abersailbot/dewi-hardware/firstdraftwiringdiagramdewi.jpg

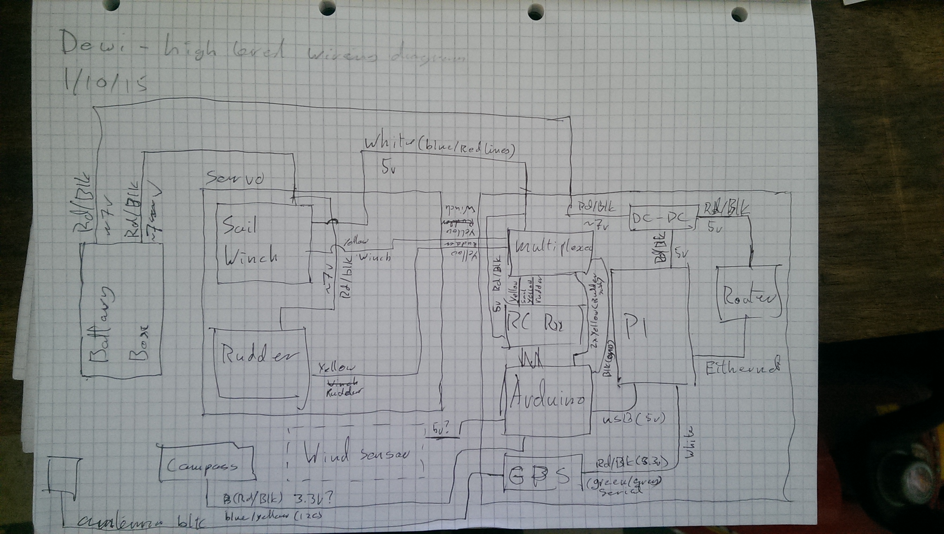
firstdraftwiringdiagramdewi.jpg
