abersailbot/dewi-hardware/README.md

# dewi-hardware
Hardware designs and issue tracking for Dewi.
