abersailbot/dewi-hardware/hardware-spec.rst

===============
Dewi's hardware
===============

Weight: 17.5kg (full electronics, without batteries)
