abersailbot/dewi-hardware/(list of files, drawings)

Other design files:
pi-expansion/Pi-Expansion.dsn
