abersailbot/dewi-hardware/pi-expansion/Pi-Expansion.kicad_pcb

## KiCad design pi-expansion/Pi-Expansion.kicad_pcb (2016-11-21, last stored version)

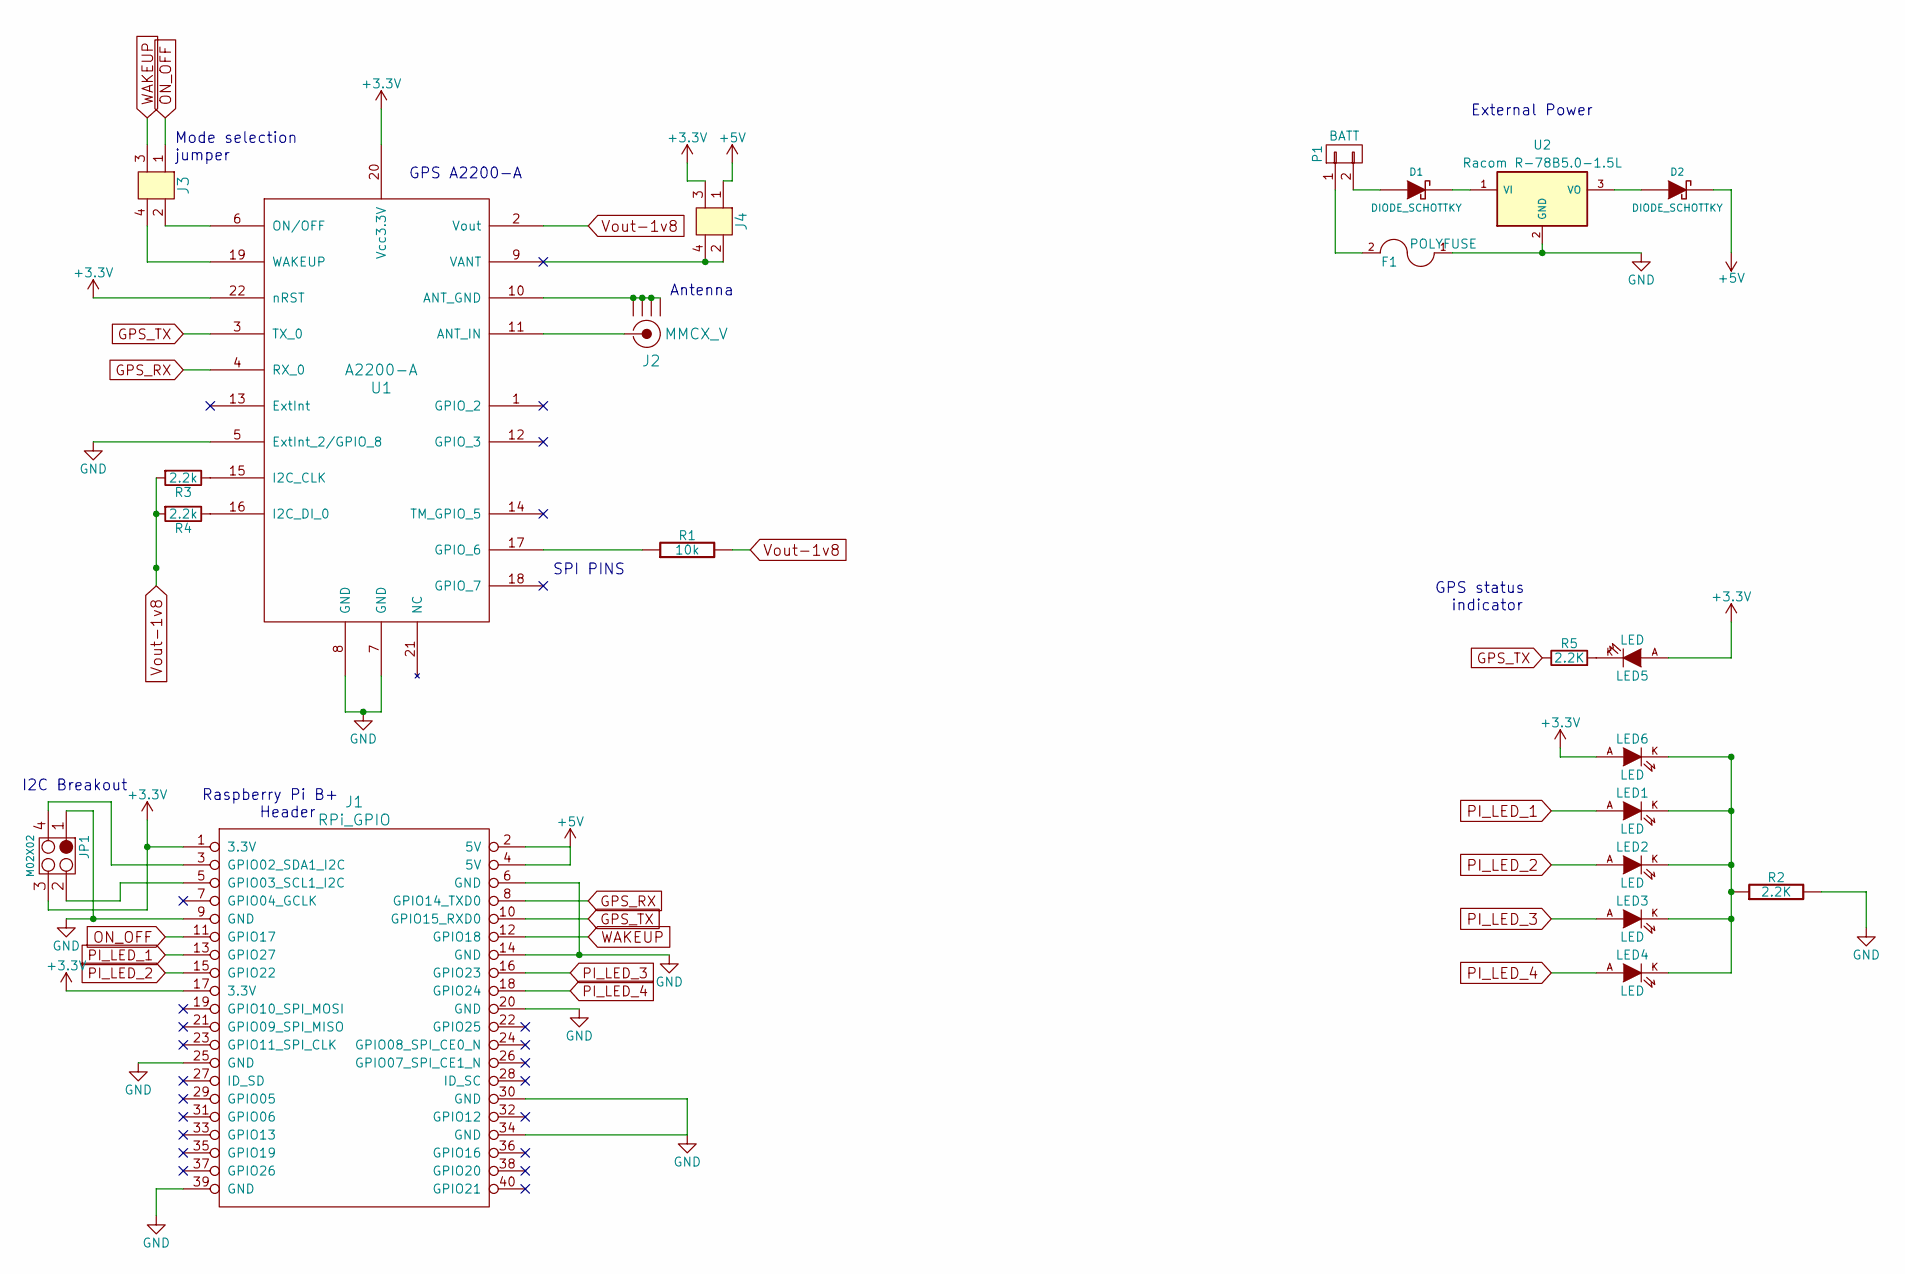
[picture p2: schematic Pi-Expansion.sch, Captain H.Morgan]

Parts:
D1, D2: DIODE_SCHOTTKY; SOD-323
F1: POLYFUSE; Fuse_SMD1206_HandSoldering
J1: RPi_GPIO; Pin_Header_Straight_2x20
J2: MMCX_H; MMCX_V; Manufacturer Part Number 142-0711-821
J3, J4: PINHEADER_2X2_SMD; Pinhead_2x2_SMD; Manufacturer Part Number 0015912040
JP1: M02X02; Socket_MOLEX-KK-RM2-54mm_Lock_4pin_straight
LED1, LED2, LED3, LED4, LED5, LED6: LED; LED-1206
P1: BATT; Socket_MOLEX-KK-RM2-54mm_Lock_2pin_straight
R1: 10k; 1206
R2, R5: 2.2K; 1206
R3, R4: 2.2k; 1206
U1: A2200-A
U2: Racom R-78B5.0-1.5L; DCDC-Conv_Recom_R-78HBxx-0.5

Connections:
+3V3: J1.1 (3.3V), J1.17 (3.3V), J4.3, JP1.3, LED5.A, LED6.A, U1.20 (Vcc3.3V), U1.22 (nRST)
+5V: D2.K, J1.2 (5V), J1.4 (5V), J4.1
GND: F1.1, J1.6 (GND), J1.9 (GND), J1.14 (GND), J1.20 (GND), J1.25 (GND), J1.30 (GND), J1.34 (GND), J1.39 (GND), JP1.1, R2.2, U1.5 (ExtInt_2/GPIO_8), U1.7 (GND), U1.8 (GND), U2.2 (GND)
GPS_RX: J1.8 (GPIO14_TXD0), U1.4 (RX_0)
GPS_TX: J1.10 (GPIO15_RXD0), R5.1, U1.3 (TX_0)
unnamed: D1.A, P1.2
unnamed: D1.K, U2.1 (VI)
unnamed: D2.A, U2.3 (VO)
unnamed: F1.2, P1.1
unnamed: J1.3 (GPIO02_SDA1_I2C), JP1.4
unnamed: J1.5 (GPIO03_SCL1_I2C), JP1.2
unnamed: J2.1 (RF), U1.11 (ANT_IN)
unnamed: J2.2 (GND1), J2.3 (GND2), J2.4 (GND3), J2.5 (GND4), U1.10 (ANT_GND)
unnamed: J3.2, U1.6 (ON/OFF)
unnamed: J3.4, U1.19 (WAKEUP)
unnamed: J4.2, J4.4, U1.9 (VANT)
unnamed: LED1.K, LED2.K, LED3.K, LED4.K, LED6.K, R2.1
unnamed: LED5.K, R5.2
unnamed: R1.1, U1.17 (GPIO_6)
unnamed: R3.1, U1.15 (I2C_CLK)
unnamed: R4.1, U1.16 (I2C_DI_0)
ON_OFF: J1.11 (GPIO17), J3.1
PI_LED_1: J1.13 (GPIO27), LED1.A
PI_LED_2: J1.15 (GPIO22), LED2.A
PI_LED_3: J1.16 (GPIO23), LED3.A
PI_LED_4: J1.18 (GPIO24), LED4.A
Vout-1v8: R1.2, R3.2, R4.2, U1.2 (Vout)
WAKEUP: J1.12 (GPIO18), J3.3

Notes on the sheet:
SPI PINS
Mode selection jumper
GPS A2200-A
I2C Breakout
External Power
GPS status indicator
Raspberry Pi B+ Header
Antenna

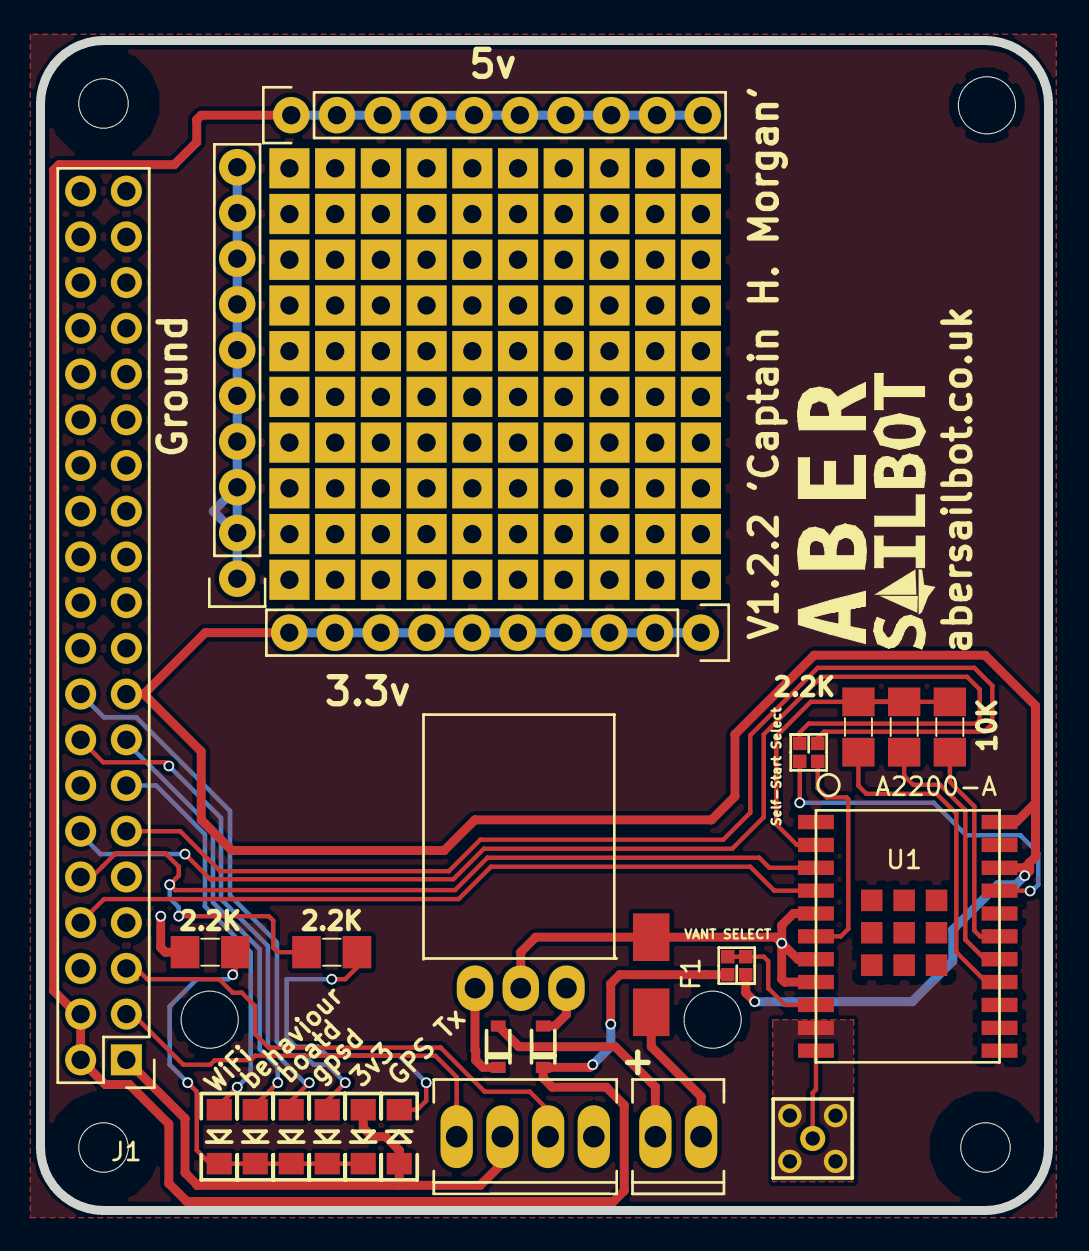
[picture p3: board Pi-Expansion.kicad_pcb from above]

Board: 2 copper layers, 56.0 x 65.0 mm, 27 parts (0 on the bottom side), 28 nets.

Other parts of the board:
1111, 1112, 1121: RPi_Hat_Mounting_Hole
ARDUINO_SHIELD: val**; ARDUINO_SHIELD_3_HOLE
svg2mod: G***; Sailbot_Logo
