abersailbot/dewi-hardware/(threads)

Thread 1 (2015-08-31):

Fix Handle

Danyc0, 2015-08-31:
The front handle of Dewi needs fixing so that the jib can be attached. Will need Epoxy and Fibreglass we have to find somewhere.

Do not close this ticket until the sails have been attached and tensioned. Re-open if the handle breaks again

Danyc0, 2015-09-01:
Handle fixed, waiting for attaching and tensioning to close the ticket

Closed 2015-09-01.

Thread 10 (2015-08-31):

Build new wind sensor

colinsauze, 2015-08-31:
Build a new wind sensor and wind sensor mast to replace the previous lost/broken one. Possibly integrate Halie's luffing sensors.

TomGC96, 2016-05-17:
New Wind Sensor and Vane attached

Closed 2016-05-17.

Thread 2 (2015-08-31):

Fix Keel

Danyc0, 2015-08-31:
Epoxy and fibreglass the bottom of the keel back onto Dewi's hull. The broken part of the keel can be found in a clear clipped plastic box.

Do not close this ticket until the epoxy has set and has had some gentle strength testing. Re-open this ticket if the it breaks again

Danyc0, 2015-09-01:
Keel fixed!

Closed 2015-09-01.

Thread 5 (2015-08-31):

New Stand

colinsauze, 2015-08-31:
Make a new stand that is:
1. collapsable
2. lightweight
3. has two wheels

naturesyouth, 2015-09-04:
and go faster flames

Tebazil12, 2016-06-05:
Fixed old stand

TomGC96, 2016-06-05:
Have created a new portable stand for Dewi, however may need some adjusting and requires attaching side beams.

TomGC96, 2016-06-17:
New portable stand has been sanded to fit and side beams have been attached.

Closed 2016-06-17.

Thread 6 (2015-08-31):

Fix power distribution

colinsauze, 2015-08-31:
Reconnect 5V regulator/DC-DC converter. Make sure that GPS and compass have 3.3V power supplies, should be we use the Arduino 3.3V output to do this?

colinsauze, 2015-09-04:
Power distribution done.

Closed 2015-09-04.

Thread 7 (2015-08-31):

Reconnect GPS

colinsauze, 2015-08-31:
Reconnect the GPS USB to serial converter and power supply.

naturesyouth, 2015-09-01:
gps works, but the wire loom needs fixing

colinsauze, 2015-09-04:
GPS reconnected and working.

Closed 2015-09-04.

Thread 8 (2015-08-31):

Reconnect compass

colinsauze, 2015-08-31:
Reconnect the compass power (3.3V) and I2C bus including pullups (to 5V????).

naturesyouth, 2015-09-01:
compass is now working and soldered to headers

colinsauze, 2015-09-04:
Compass reconnected and working.

Closed 2015-09-04.

Thread 11 (2015-09-04):

fully water electronics and battery boxes

naturesyouth, 2015-09-04:
improve the water proofing on the internal boxes

Tebazil12, 2016-12-21:
This should be mostly solved by now using cables (instead of lots of individual wires) as the glands tighten nicely around them and should seal. But, a few of the glands look very bent out of shape and a couple are missing the rubber bit that helps seal them, so this need looking into to make sure they are definitely waterproof.

Danyc0, 2016-12-22:
The "rubber bit that helps seal them" is actually the bit that does all the waterproofing, without it they're not waterproof. There should be some glands around the place which can be cannibalised for the seals.

Danyc0, 2016-12-22:
Also, are there any glands on the boxes which don't have any wires in them at all? As they will likely cause an issue. In the past we've filled them with hot glue as a temporary measure, but that's not gonna be IP67!

Tebazil12, 2016-12-22:
Do you know the size/make of the glands so we can find spare parts? Someone suggested we find the top bit of the gland without a hole for wires, so its covered and watertight.

Danyc0, 2016-12-22:
@colinsauze might know. What do you mean by "find the top bit of the gland without a hole for wires, so its covered and watertight" ?

Danyc0, 2016-12-22:
What really needs to happen, is just to do #55 and use some sort of waterproof connecter (similar to that which is in kitty), instead of glands

Thread 12 (2015-09-04):

Opto isolate servo data lines

colinsauze, 2015-09-04:

naturesyouth, 2016-12-02:
This issue was moved to abersailbot/captain-h-morgan#6

Closed 2016-12-02.

Thread 13 (2015-09-04):

Short and reverse polarity protection

colinsauze, 2015-09-04:
Diodes on power input lines. Fuses between batteries and power winch/main system. Investigate poly fuses and other resettable solutions.

naturesyouth, 2016-06-17:
electronics now have fuses and reverse polarity protection using diodes. not sure if a fuse is needed between the batteries and servos.

Closed 2016-06-17.

Thread 14 (2015-09-04):

Build more charging cables

colinsauze, 2015-09-04:
So that all 4 batteries can be charged simultaneously.

Tebazil12, 2016-06-05:
One more built, need another one

Tebazil12, 2017-05-24:
Has this been completed?

TomGC96, 2017-05-24:
I think we could do with one more to go from the charger, to the batteries. You can make a direct Banana Plug to Battery cable, because it won't be used for anything else. Finding the banana plugs might be your only issue.

TomGC96, 2019-08-21:
@naturesyouth - I believe you have created more charging cables. Can this now be closed?

naturesyouth, 2019-08-21:
this is complete, with the exception of two batteries that remain Tamiya'd, if we can got more connecters this can be closed

Thread 16 (2015-09-04):

Power monitoring

colinsauze, 2015-09-04:
Monitor battery voltage and currents on various devices.

colinsauze, 2016-11-30:
We are currently looking at using the INA219 at work. Its an I2C current/voltage monitor able to monitor up to 3.2A and 26V. See https://www.adafruit.com/product/904

naturesyouth, 2016-11-30:
that looks pretty cool, definitely worth looking into.

naturesyouth, 2016-11-30:
could this be spun into board in the battery box? that way we can monitor both sides of the power system?

Danyc0, 2016-12-01:
IIRC, based on the measurements I took last year, with both wifi dongles running, especially if there's now a Pi3 (plz no), and we're doing a lot of CV we will overrun that 3.2A limit

naturesyouth, 2016-12-01:
I would think we would have one chip per channel / battery rather then one for everything. and was that including servos? because the power supply for the logic isn't rated for anything more then an amp and a half.

Danyc0, 2016-12-01:
Now I come to think of it, I'm not sure :P Please disregard that comment :L

colinsauze, 2016-12-01:
It is possible (but hard, needs surface mount soldering) to change the shunt resistor and adjust its measurement range. But 3.2A max for the whole boat sounds about right to me. If there are multiple sensors then you shouldn't saturate them.

TomGC96, 2016-12-01:
Yeah you do not remember correctly, the measurements for current I took for the Pi, Arduino and Captain Morgan hardly reached 0.5A.

Thread 17 (2015-09-04):

Extra ballast

colinsauze, 2015-09-04:
More epoxy to hold in existing lead and extra lead.

TomGC96, 2016-06-17:
The only issue we may experience here is that permanently adding more lead might take us over the 32KG limit for checked luggage. We currently have stones stuck under the deck adding some weight.

TomGC96, 2016-09-06:
Another idea to consider in future is sand bags.

Thread 18 (2015-09-04):

External radio atennas

colinsauze, 2015-09-04:
External antennas for Xbee, Wifi and RC. If on same frequency (e.g. 2.4 ghz) antennas should be at different heights to avoid interference.

TomGC96, 2017-05-27:
One external antenna has been mounted on the deck for WiFi.

TomGC96, 2017-06-14:
2 external antennae have been attached to the deck, using Bulgin 400 Series Miniature Connectors. These have drastically increased our range for both XBee and WiFi.

Closed 2017-06-14.

Thread 19 (2015-09-04):

Shield all cables that go outside the box.

colinsauze, 2015-09-04:
Use shielded cables whereever possible on signal lines. Twist power and ground cables together.

Tebazil12, 2016-12-21:
The data wire (yellow) leading to the rudder servo is now shielded. Only the wire leading to the sailwinch should now need shielding.

Danyc0, 2016-12-22:
Just to double check, is one (and only one) end of all the shielding attached to an earth?

Danyc0, 2016-12-22:
And are the ground and power lines twisted?

Tebazil12, 2016-12-22:
Not earthed yet, most of the wires haven't been reattached to the bits inside the boxes after I replaced the wires with cable. And no, the power and ground are not twisted, should they be?

Danyc0, 2016-12-22:
Ah ok! It's in the note for this issue to twist them together, it's just another thing to try and combat interference

Tebazil12, 2016-12-22:
I didn't see that bit, whoops. The power lines are mostly cable now, so theres no way of twisting them together.

Danyc0, 2016-12-22:
As long as they're close enough, it should be ok

Tebazil12, 2017-05-24:
ok, so at this stage only the data wire to the rudder has been shielded, not the sail winch. I am not sure if it is worth redoing the wiring again to make it shielded (unless interference really is a big problem)

Danyc0, 2017-05-24:
Interference, specifically on the sail winch has been a very big problem in the past. Especially with certain RC remotes. When interference happens on the winch, it can often go past it's end stops and try to draw the sail in too far, which then breaks the winch. It's probably the most important cable of them all. Definitely worth doing, although if it's fine for now, then it should be ok for testing, but competitions have a lot more RF interference from everyone else's remotes, which is where the noise was worst, so it should probably be done before Sailbot.

Thread 20 (2015-09-04):

Affix cables to boat.

colinsauze, 2015-09-04:
Affix wires external to electronics boxes to the hull. Leave enough slack to remove boxes from hull.

Tebazil12, 2016-06-27:
This has been done with tape, but will need probably need re-doing with something stronger.

Tebazil12, 2016-12-21:
Has now been fixed with cable ties and cable tie mounts near the hatch, but might need more further inside the boat as they are very slack.

Danyc0, 2017-06-01:
@Tebazil12: How'd this go? Last I heard It was nearly done?

Thread 21 (2015-09-04):

PCB on Pi

colinsauze, 2015-09-04:
Put the AtMega and power distribution, possibly regulator on PCB that fits ontop of Pi.

naturesyouth, 2016-02-14:
At least part of this is being integrated on the mounting solution for #45

naturesyouth, 2016-02-14:
See abersailbot/dewi-hardware/pull/49

naturesyouth, 2016-06-17:
Version 1 has already be deployed at sailbot, and version 1.2 will be fabbed over semmer for WRSC

Danyc0, 2016-06-18:
This should be closed when the PCB has been tested and is 100% working in fabbed state, with no extra jumper wires, etc. Think "done done".

naturesyouth, 2016-12-02:
This issue was moved to abersailbot/captain-h-morgan#1

Closed 2016-12-02.

Thread 22 (2015-09-04):

Find and fit new Mast Joiner

colinsauze, 2015-09-04:
Put a new pin in the mast to keep it straighter.

TomGC96, 2016-05-18:
New mast joiner has been fitted in the form of an aluminium pipe. Attached to the top mast section with a screw (a hole has been threaded in the pipe). To remove or attach the mast sections to each other, the top cable tie must be cut.

Closed 2016-05-18.

Thread 23 (2015-09-04):

Boom attachment screw needs replacing.

colinsauze, 2015-09-04:

Tebazil12, 2016-12-21:
Which screw was this exactly? The screw attaching the kicker to the mast?

Danyc0, 2016-12-22:
Kinda, IIRC it's the screws that hold in place the black thing which attaches both the boom and the kicker to the mast

Tebazil12, 2016-12-22:
ok, I think currently the old screw(s) are being supported by lots of cable ties, but new screws probably would be best as well. Any idea the exact size of them so we can get some ordered?

Danyc0, 2016-12-22:
I think there might be some missing, not sure though. No idea in the slightest with regards to the screw size, which is the main problem really

Thread 24 (2015-09-04):

Kicking strap is causing hole in boom to enlarge.

colinsauze, 2015-09-04:
Reinforce boom to stop this and shorten kicking strap.

kragniz, 2016-05-23:
@TomGC96 added a carbon fiber sheath around the boom for this. It seems to have worked well so far.

Closed 2016-05-23.

Thread 26 (2015-09-04):

Replace missing nuts on rudder linkage.

colinsauze, 2015-09-04:

TomGC96, 2016-05-17:
New nuts found and attached to rudder linkage

Closed 2016-05-17.

Thread 27 (2015-09-04):

Replace servo horn.

colinsauze, 2015-09-04:
With one that is a single piece and won't detach. Ideally metal.

TomGC96, 2016-05-28:
Servo horn replaced with aluminium horn. Spares also sourced.

Closed 2016-05-28.

Thread 28 (2015-09-04):

Add bumper strip around edge of hull.

colinsauze, 2015-09-04:
Especially at the bow. This could make the difference between serious damage and no damage in a collision.

naturesyouth, 2015-12-02:
Some strip added but not at bow end

kragniz, 2016-01-26:
@Tebazil12 @naturesyouth What's the status of this? Are there plans to get the bow done?

CloudCoppola, 2017-04-26:
We have the rubber material.

Need to repair the dents, repaint it and then add bumper.

Note: Make sure Dewi still fits in travel box once the bumper has been added.

Thread 29 (2015-09-04):

Fix back of keel properly.

colinsauze, 2015-09-04:
Insert a metal rod into keel to reinforce it.

naturesyouth, 2015-12-02:
Fixed with epoxy putty but not reinforced

thip, 2015-12-02:
It will just break again... it needs the reinforcement

TomGC96, 2016-06-17:
Back of keel has been repaired with a mixture of epoxy, microfibres and colloidal silica. It has been sanded down but will need to be re-painted.

Danyc0, 2016-06-18:
This should probs get closed when the re-painting gets finished, so that it's "done done"

TomGC96, 2016-06-18:
I'll open another issue, seeing as this specific task has been completed.

Closed 2016-06-18.

Thread 30 (2015-09-04):

Better handles.

colinsauze, 2015-09-04:
Try to improve handles so they are more comfortable and larger. Front handle is structural for the jib to deck connection.

TomGC96, 2016-06-17:
Since the front handle has broken off it will need to be fully replaced or removed. Currently the front block has been screwed to the deck and an eyelet has been attached to connect the jib boom.

TomGC96, 2016-09-12:
The front handle has now been fully replaced with a stainless steel eye plate screwed in with stainless steel screws and sealed with silicone. This allows the jib to be tied down, as well as allowing us to use a rope handle which can be detached when necessary. It has been tested and found to be working satisfactorily, though the rope handle could be made a little more comfortable by surrounding it with PVC tubing. This closes the issue for the time being, but it can be re-opened if it is found to be unsuitable.

Closed 2016-09-12.

Thread 31 (2015-09-04):

Add painter (tow rope) attachment point

colinsauze, 2015-09-04:

NicholasRostant, 2016-09-05:
New and very solid anchor point for painter introduced

TomGC96, 2016-09-06:
To add for future reference, a stainless steel deck eye plate has been attached with stainless steel screws and sealed with clear silicone to ensure it's water tight.

Closed 2016-09-05.

Thread 32 (2015-09-04):

Add easy access power switch

colinsauze, 2015-09-04:
This should probably be inside the hatch but on top of the box or outside the box.

TomGC96, 2016-06-17:
@naturesyouth You had a nice waterproof 3 position button you showed us last year. Was that what we were thinking?

naturesyouth, 2016-06-17:
i don't think the one i have is waterproof, but waterproof switches are fairly easy to get hold of

Danyc0, 2017-06-01:
I was thinking something like this: http://uk.rs-online.com/web/p/rocker-switches/9132825/

Thread 34 (2015-09-04):

Masthead LEDs

colinsauze, 2015-09-04:
White at front, green starboard, red port LEDS. These should be self powered to avoid additional cables through the deck.

Thread 35 (2015-09-04):

Add AIS receiver

colinsauze, 2015-09-04:
Use RTLSDR or similar low power receiver to receive AIS signals and integrate with collision avoidance.

Thread 36 (2015-09-04):

Underclock Pi

colinsauze, 2015-09-04:
Reduce clock speed to reduce power consumption.

kragniz, 2015-09-04:
It would be interesting to benchmark this to see how much power saving we could get here.

TomGC96, 2019-08-21:
Given the time we have seen the computers run on one charge (Long Distance race at Sailbot in Annapolis) I believe this can be closed. With plans to use computers for vision this will also most likely prove to be impractical. If we find battery life to become an issue we can re-open.

Closed 2019-08-21.

Thread 37 (2015-09-04):

Vision system/camera

colinsauze, 2015-09-04:
Add a camera for collision avoidance events.

Danyc0, 2017-06-01:
Has anyone done anything on this lately? And if not, do we still have the rushed together code from WRSC 2016 as maybe a starting point?

Thread 38 (2015-09-04):

Replace dedicated wifi router with wifi on board pi

kragniz, 2015-09-04:
A la kitty's setup.

naturesyouth, 2016-02-01:
removed the wifi router and ethernet cable, did some checking and the currently fitted wifi adapter should have no hardware issues. i will write up a conf file to setup the wifi as an ap on startup

naturesyouth, 2016-06-17:
this has been done, the router is removed and pi based wifi is done

Closed 2016-06-17.

Thread 40 (2015-09-04):

Create a wiring standard

colinsauze, 2015-09-04:
Specifying:
standard wiring colours for common buses,e.g. i2c or serial
maximum wire lengths
wire thicknesses
shielding

naturesyouth, 2015-12-02:
latest versin of wiring standard created at this time can be found at https://github.com/abersailbot/management/blob/master/sailbot-wiring-standard.md

Danyc0, 2016-11-24:
Should this be closed?

naturesyouth, 2016-11-24:
i don't think i ever finished it to the spec of this issue, and this would be nice to establish before too many renovations are done on kitty

Danyc0, 2016-11-24:
Good plan

Thread 43 (2015-09-07):

Find a better fitting rudder pin

Danyc0, 2015-09-07:
Find a better fitting rudder pin to significantly reduce the wobble in the rudder assembly

TomGC96, 2016-05-24:
Mark suggested to ask Barry for a welding rod of 4mm (diameter of the smallest hole). If he remembers he will do so when he next sees him.

kragniz, 2016-05-24:
Fitting pin has been sourced.

Closed 2016-05-24.

Thread 44 (2015-09-07):

Reprogramme the sail winch to shrink its maximum travel

Danyc0, 2015-09-07:
Reprogramme the sail winch to shrink its maximum travel by a few cm

TomGC96, 2016-05-25:
The sail winch has been correctly calibrated, as we had to change the sail winch.

Closed 2016-05-25.

Thread 45 (2015-09-09):

Fix Pi/Arduino mounting inside main electronics/'Computers' box

Danyc0, 2015-09-09:
Fix the Pi/Arduino mounting inside main electronics/'Computers' box. At the moment it's built of an old drinks bottle i think, which is causing the pi to get rather hot

naturesyouth, 2016-01-20:
started working on an interface board

naturesyouth, 2016-02-14:
See abersailbot/dewi-hardware/pull/49

Tebazil12, 2017-05-24:
Can this issue be closed now?

Danyc0, 2017-06-01:
@naturesyouth @Tebazil12: Is this closable?

Closed 2019-07-29.

Thread 48 (2016-02-14):

Alternative methods of Arduino programing

naturesyouth, 2016-02-14:
It would be nice if someone could look into the possibility of programming the Arduino without a usb connection, either over spi or serial, preferably with some hardware experimentation. This is in refrence to #45

Danyc0, 2016-02-14:
So this page explains how to program an arduino using another arduino:
https://www.arduino.cc/en/Tutorial/ArduinoISP
I reckon if you reimplemented the ArduinoISP example (found built into the IDE these days) for the Pi it might just be possible. However I think that would take too much time to be worth it just for the purpose of getting rid of a USB cable

naturesyouth, 2016-12-02:
This issue was moved to abersailbot/captain-h-morgan#4

Closed 2016-12-02.

Thread 50 (2016-05-17):

Buy more struts for bottom of box & attach

TomGC96, 2016-05-17:
The bottom of the box could do with 2 more struts to reinforce it a little more, we only have 1 which fits at the moment.

TomGC96, 2016-05-25:
Aluminium plate Araldited to bottom of box, one strut attached over plate directly in front of keel.

Closed 2016-05-25.

Thread 51 (2016-05-17):

Attach castors to trolley base

TomGC96, 2016-05-17:
12 bolts are required to attach 3 remaining castors to trolley base, located in the shed.

kragniz, 2016-05-27:
I don't think we're going to do this. The box needs to leave soon and it's fairly easy to carry the box with two people using the holes cut for handles.

Closed 2016-05-27.

Thread 53 (2016-06-18):

Re-paint Dewi

TomGC96, 2016-06-18:
The entire boat needs re-painting. Paint has started flaking off in places and is causing the wood to absorb some water. The bottom of the keel where a repair has been made should be re-painted sooner as it stands out.

kragniz, 2016-06-18:
More importantly, the balsa around the edge needs to be resealed. This should probably be done with something better than paint, then painted over when that is done.

TomGC96, 2017-05-27:
The balsa around the edge has been sealed with 2 coats of epoxy, and is ready to be re-painted.

TomGC96, 2017-06-01:
All holes in the hull of the boat have been filled in, and the entire boat has been sanded smooth in order to remove paint. We have also primed the hull with 2 coats of PlastiKote Grey Primer spray - she is now ready to be painted to her famous colours, with PlastiKote Gloss Super spray paint.

TomGC96, 2017-06-02:
The deck and top edges of the hull have now been painted yellow. This will be dry by Monday. I will then paint the orange hull of the boat on Tuesday night, in order for it to dry by the time we depart on Friday.

Danyc0, 2017-06-02:
What's the plan for the orange painting? Straight line or the nice wavy thing we had recently? And if the latter, how do you plan of doing the wavy bit?

TomGC96, 2017-06-06:
To be honest, I hadn't realised it was on purpose until I was told, I thought it was a straight line gone wrong. How do people want me to do it?

kragniz, 2017-06-06:
I personally like wavy

TomGC96, 2017-06-06:
How did you do the waviness? Or was it just guesswork? That could be difficult to get right.

Tebazil12, 2017-06-06:
Looking at the old paint, they had a straight line then made it curved after. You could put a straight line of masking tape all the way around, then put more tape on at the front and back to make the curve, if that makes sense? (There might be an easier way though)

TomGC96, 2017-06-08:
A different paint was used for the underside of the boat in the end, which was Rust-Oleum Quick Colour Orange. Dewi has now been fully re-painted to her original colours!

Closed 2017-06-08.

Thread 54 (2016-06-18):

Replace hatch's O-ring

Tebazil12, 2016-06-18:
The current o-ring is no longer watertight

Closed 2017-04-26.

Thread 55 (2016-06-18):

Replace electronics box

Tebazil12, 2016-06-18:
The current box uses glands. Replace this with a box that uses connectors so the box can be easily unplugged and removed from the boat.

Thread 56 (2016-08-31):

Connect GPS Pin 9 to 3.3V for Active Antenna

TomGC96, 2016-08-31:
At the moment the board is set up for a passive antenna, however we are using the ANT-555 active antenna.

naturesyouth, 2016-09-01:
yeah, i remember this being discussed, there is a jumper selection footprint in the project so i will add that in when i get a spare moment.

naturesyouth, 2016-11-30:
this has been fixed

Closed 2016-11-30.

Thread 57 (2016-09-05):

More robust way to connect wires to the Arduino

NicholasRostant, 2016-09-05:
The current method is not particularly reliable and difficult to notice when a connection has gone wrong.

naturesyouth, 2016-09-05:
in the kit i sent with the new gps board there a collection of 2.54mm right angle latching connectors, can these be soldered to the underside of arduino pins? That would make it almost impossible to plug the wire in the wrong way, and be a lot more robust than the current connection.

Tebazil12, 2016-11-30:
Currently changing from an uno to a nano. Plan so far is to use veriboard and headerpins to connect to the nano instead of just headerpins, and attach everything to the lid of the box, instead of the bottom. This should stop the wires being tugged on every time the box is opened.

Danyc0, 2016-12-01:
What's the plan for securing it to the lid?

Tebazil12, 2016-12-01:
Currently hot glue, but still trying to think if theres anything better.

Just to clarify, by 'attach everything to the lid of the box' I meant nano and veriboard, not Capt Morgan and pi (those will remain in the bottom of the box).

Tebazil12, 2017-05-24:
this is mostly complete now, the arduino just needs testing to make sure everything was rewired correctly

Thread 58 (2016-09-08):

Find an alternative switch mode regulator for Captain H Morgan

Danyc0, 2016-09-08:
The DC-DC converter on CHM overheats and starts cutting its output at 71 degrees C, causing brown-outs on the arduino (but not the pi, probably because it can deal with a lower voltage). It then cuts out completely at 85 degrees C IIRC. An alternative is to find a way to keep everything cooler, because the whole board stack gets very (very) hot.

naturesyouth, 2016-09-08:
which rev of the board is this fault on? also can we get a current reading on the batt supply with everything plugged in?

Danyc0, 2016-09-08:
V1.2, and no. I'm pretty sure we're going over the 1A limit, we should use this instead: R-78Bxx-1.5(L), it supports up to 1.5A

naturesyouth, 2016-09-08:
hmm, we should already be using the 1.5A dc-dc, and when we did out calculations we should have been well under an amp...

TomGC96, 2016-09-09:
@naturesyouth is correct, yes, we are using the 1.5A regulator.

Danyc0, 2016-09-13:
Ah ok, well we still need to either find a replacement, or find another way to keep the box cool, as it's very much overheating. There is currently a tiny python script I wrote sitting on the Pi called temp.py which will both log and output the Pi's chip temperature once every 5 seconds

Danyc0, 2016-09-13:
The Arduino also has a cut off at 85 degrees C so maybe we just need to find a way to keep the box cooler. Increasing the height of the standoffs might help

naturesyouth, 2016-11-21:
can we run a test for whats making the most heat, i recon the best way to do this is setup a second arduino with some temp sensors fixed to various parts of the electronics as well as inside and outside the box, and then running  untill the overheat happens,

Danyc0, 2016-11-21:
Might be a good idea, there's a temperature sensor built into the IC on the Pi, and I build a rubbish little script which logs its data, but it only exists on the Pi we took to WRSC

naturesyouth, 2016-12-02:
This issue was moved to abersailbot/captain-h-morgan#3

Closed 2016-12-02.

Thread 59 (2016-09-08):

Fix power cables in the battery box

Danyc0, 2016-09-08:
The power cables in the battery box (including those coming directly out of the batteries) are very badly fitting and constantly cause reboots of the Pi and the Servos. The cables need replacing and a better solution to the wires coming from the batteries needs to be found

Danyc0, 2017-06-02:
Has anything been done to this? because it was a pretty major problem

TomGC96, 2017-06-02:
It hasn't been done yet, however I think we agreed the best solution would probably be to cut the cables on the batteries and attach Dean's connectors. I intend to do this during the coming week.

Danyc0, 2017-06-02:
A fair solution, just keep in mind it means you won't be able to borrow batteries at the competition, so make sure you take spares!

TomGC96, 2017-06-04:
It wouldn't make any difference in that sense, as we would still take the Tamiya to Dean's converter cable - so switching back would not be an issue.

Thread 60 (2016-09-11):

New rudder

kragniz, 2016-09-11:
Our current rudder is too short and cannot control the boat properly when it is heeling in strong winds. The current rudder could be extended to match the original modified rudder that was lost, but a clean start would be nicer.

TomGC96, 2017-02-27:
I've contacted Paul Miller to ask about the rudder. Although he mentions that the transom hung rudder is the least efficient, the new rudder should be a NACA 0012 airfoil section, 75mm in chord, and the length should be to the bottom of the keel, -1cm to avoid damaging the rudder when putting the boat down or running her aground (hopefully this won't happen).

TomGC96, 2017-06-01:
After speaking to Barry, it became apparent that milling balsa to form a rudder would be difficult as it will be very thin. It seems a better way to make a replacement rudder, would be to cut various small pieces of NACA 0012 airfoil section, and joining them together as seen here. This should then be sanded, shaped, and sealed.
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

Danyc0, 2017-06-01:
Would something like high density foam be better for milling? Because I think that's better than balsa in almost every way re: rudders.

TomGC96, 2017-06-01:
This was also discussed previously with Barry, and the answer was no, as it would likely be more flexible and not as firm. It would also add unnecessary weight, and is expensive. But as mentioned, the suggestion was that avoiding milling would be best for our situation.

Danyc0, 2017-06-01:
My memory of the foam we used for kitty, was it was like 10 pounds for the amount we'd need. I'm pretty sure it's also lighter. Also, all the rigidity comes from the epoxy/fibreglass, the foam is effectively just a mould, ideally it could be dissolved after the fibreglass is added. That's why @kragniz used it for kitty.

colinsauze, 2019-08-21:
Completed by @linemcr

Closed 2019-08-21.

Thread 61 (2016-09-13):

Add a cooling system to the electronics box

TomGC96, 2016-09-13:
In WRSC in Portugal we found the switch mode regulator overheating and causing a loss in power. At the moment we have it mounted on a PCB between the Pi and Arduino. A fan may be enough to create some airflow within the box, or we could be ambitious and create a water cooling system pumping water from outside the boat.

CloudCoppola, 2017-03-08:
Couldn't we just put in a gel cooling pad with the electronics?

CloudCoppola, 2017-05-27:
Best to measure inside the box (width, length and height). But I've found this
https://www.amazon.co.uk/gp/product/B00INCVS08/ref=s9_dcacsd_dcoop_bw_c_x_3_w?th=1

Danyc0, 2017-05-30:
Aren't those things basically just the capitalist version of a tea towel. I think it might get burnt if it was stuck to the pi.
If however you were talking about the cooling pack itself (which that is totally not the link for), I'd say that they're gonna create loads of condensation and moisture in the box and should really be avoided

CloudCoppola, 2017-06-02:
I'm not sure if your on about the ice pack or gel pack which I was mentioning, but It was either that idea or redesigning Dewi with a water cooling system. Better to do that than adding a heat sink and cooling fan for obvious reasons.

naturesyouth, 2017-06-02:
If i recall the problem only occurred when the boat was out of the water in a sealed box with high ambient temperature, so having the box open and a fan would solve the issue, just make sure the boat isn't running sealed up on the dock. no major hardware mods needed.

CloudCoppola, 2017-06-02:
Then that's just as easy as buying a cheap handheld battery powered fan and keeping it inside the box until she goes out again.

Danyc0, 2017-06-02:
The gel packs still cause condensation IIRC. I'd say just a heat-sync on the Pi would be enough, the problem is that it's all so close together with Captain Morgan now, so a good heat-sync which gets the heat away from the super enclosed space between the Pi and the PCB should do the job.

Thread 62 (2016-09-19):

change the diode footprint for the power diodes

naturesyouth, 2016-09-19:

TomGC96, 2016-12-01:
What's the progress on this @naturesyouth?

naturesyouth, 2016-12-02:
This issue was moved to abersailbot/captain-h-morgan#2

Closed 2016-12-02.

Thread 63 (2016-09-28):

Build hardware in the loop simulator

colinsauze, 2016-09-28:
Duplicate all the electronic internals of Dewi (Pi+Arduino+Captain Morgan and maybe servos) and leave them somewhere hooked up to mains power+internet. Use this to run long term testing. A simulator could be adapted to simulate NMEA GPS output and a second arduino could pretend to be an I2C compass and wind sensor. Telemetry output from the control system could provide actuator positions back to the simulator.

naturesyouth, 2016-09-28:
this would be a fantastic project to get freshers on. Get them familiar with how everything works

Thread 64 (2016-10-05):

Replace Remote Control Receiver

TomGC96, 2016-10-05:
The RC receiver's wires have been cut, it would be good to replace it and connect it to an external antenna if possible.

colinsauze, 2019-07-29:
Receiver has been replaced but still doesn't have an external antenna.

Thread 65 (2016-11-21):

Secure dc-dc.

naturesyouth, 2016-11-21:
the dc-dc converters need to be glued down to the pcb to prevent mechanical stress from shearing the leads. hot glue would be best so it can be removed later.

naturesyouth, 2016-12-02:
This issue was moved to abersailbot/captain-h-morgan#5

Closed 2016-12-02.

Thread 67 (2016-12-01):

Remove brass plate

TomGC96, 2016-12-01:
The brass plate reinforcing the rudder pin collar has been affected by water resulting in copper oxide ending up on the deck. 2 screws have also rusted due to them not being stainless steel. These should be removed and replaced.

CloudCoppola, 2016-12-14:
Do we have a spare brass plate somewhere?

TomGC96, 2016-12-14:
If we use brass again the same will happen instantly. It's better to use something else.

naturesyouth, 2016-12-14:
you should switch to an aluminum plate, if you can't find one lying around you can one off ebay for cheap

TomGC96, 2016-12-14:
Aluminium also corrodes in salt water, although a little less! I'm not sure the plate is the way to go. It might be worth replacing the collar in some way.

CloudCoppola, 2016-12-14:
Well brass is waterproof so its best to use that and every now and again just clean it. Pete's sanded the plate so it looks brand new and is going to put silicon around the edges.

Danyc0, 2016-12-14:
What's the point in removing it at all if you're just gonna replace it with another brass one?

CloudCoppola, 2016-12-14:
Don't need to replay it now. It was just really dirty so just had to clean it and attach it back on.

Tebazil12, 2016-12-14:
Don't forget part of the issue was that the screws arent the right material and rusted, you'll need to find some decent ones to replace them with (probably stainless steal like tom suggested)

Tebazil12, 2016-12-14:
You might actually want to replace the brass place too btw, brass corrodes in salt water (which is what she'll be sailing in most of the time)

Danyc0, 2016-12-14:
Really there are two acceptable long-term options:
A. Replace it with a plate of a material which won't rust (good stainless steel, fibreglass, carbon fibre)
B. Remove the fiberglass tube used to attach the rudder (use gloves to avoid the fibreglass problem) and replace it with a new, stronger one, maybe carbon fibre (because obviously the forces on the rudder are too strong for fibreglass, because this is the second one of those tubes to crack on us). It'd need to be attached securely to the transom with fibreglass.

TomGC96, 2016-12-14:
I was thinking replacing the tube would be the way to go. Something stronger, and make sure it's on straight too!

Closed 2017-06-01.

Thread 68 (2016-12-07):

Find way of attaching GPS antenna to hatch lid

Tebazil12, 2016-12-07:
In the past we've used duct tape, which isn't very good. Would be better to find a nice way of attaching it, preferably in an easily removable way.

Tebazil12, 2016-12-21:
Now have used cable ties and cable tie mounts on the lid to keep the antenna in place.

Closed 2016-12-21.

Thread 70 (2017-04-26):

3D Printed Boxes

CloudCoppola, 2017-04-26:
We need something to protect the boards from shorting on other electronic moving around the box. At the moment we are using sticky tape but this isn't easy to work with and sometimes comes loose.

So we need 2-3 3D boxes.

Come in to measure for the Multiplexer, Radio and maybe Arduino.

Thread 71 (2017-04-26):

Test Compass

CloudCoppola, 2017-04-26:
Check calibration of compass to test the offset to see if is linear.

Danyc0, 2017-06-02:
Is it still an HMC6343?

TomGC96, 2017-10-02:
Compass did not cause us any problems in Sailbot 2017. No issue.

Closed 2017-10-02.

Thread 72 (2017-05-29):

Diagnose rudder servo problem

kragniz, 2017-05-29:
The rudder servo stopped being powered after test. Figure out what's wrong with it.

Danyc0, 2017-05-30:
By the sounds of what was described, it's either that the gearing has jammed, or the motor has burnt out. I'd say the former is more likely because the photo's show nothing obvious.

TomGC96, 2017-05-30:
The servo has been removed and is broken. It appears that the motor may have burnt out, judging by the smell and the fact that it takes 3 amps by powering it directly from a power supply. A replacement identical servo has been ordered, and will arrive and be fitted soon.

Danyc0, 2017-05-30:
Why order the exact same? Surely that means it might just do the same thing again?

TomGC96, 2017-05-30:
Because now is not really the time to be making big modifications to the way the boat works, considering the competition is so soon. Additionally and maybe more importantly, we have no, and have had no suggestions for any alternatives.

Tebazil12, 2017-05-31:
The last one survived 3+ years so that type is definitely good enough for now.

CloudCoppola, 2017-06-01:
Diagnoses complete.

Closed 2017-06-01.

Thread 73 (2017-06-01):

Attach Welsh Dragon figurehead to the front of the boat

CloudCoppola, 2017-06-01:
We have a red 3D printed model of the Welsh Dragon that would look perfect as a figurehead on Dewi. Measurements will have to be made in order to make sure that the figurehead would be able to fit in the crate. Perhaps making a slotting mechanism that would allow the figurehead to be locked in during sailing and easily removed for transportation.

Note: This would be for Welsh support as this is a Welsh University and also for points on style at competitions.

Thread 74 (2017-06-01):

Waterproof Testing

CloudCoppola, 2017-06-01:
Dewi took in some salt water after the testing on the last day around the batteries. Unsure as to why this happened, so waterproof testing will have to be done in order to see how the water got in.

Danyc0, 2017-06-01:
Like, actually in the battery box??

jack-webb, 2017-06-01:
Poorly worded - water around the battery box, not in it

kragniz, 2017-06-01:
No, around the outside of the battery box

Danyc0, 2017-06-01:
Few! I guess for water to get there, it could have either come through the hatch, the winch, or the new antenna connector

CloudCoppola, 2017-06-01:
My bad! I've corrected the description. Though we should test soon before going to the US.

Danyc0, 2017-06-01:
Hence the sailbot-2017 milestone tag

Thread 75 (2017-06-01):

Attach replacement rudder servo

TomGC96, 2017-06-01:
The previous rudder servo was damaged, and has since been diagnosed in issue #72. A new identical servo should be attached and tested.

TomGC96, 2017-06-14:
Rudder servo has been attached, sealed, and tested. It is now in use and working at Sailbot.

Closed 2017-06-14.

Thread 76 (2017-06-04):

Attach line between antennae and mast

Tebazil12, 2017-06-04:
Rigging can currently wrap around the new deck mounted antennae and get caught, stopping the boat from sailing properly and risks breaking the antennae.

Best solution may be to glue string to the top of the antennae to tie to the mast. Zip ties were used on the testing weekend but were hard to secure, aren't very reusable and caused the antennae to bend toward the mast as they were pulled too tight (this really isn't good for the antenna).

Danyc0, 2017-06-04:
Really the best solution is to to get an extender and run it up the mast as discussed previously. Improves range (even more) and completely removes the risk of snagging.
It should be a job for 2 / 3 zip ties (which would have to be cut for removing the mast), and completely removes the risk of antenna bend.
It should be really minimal work (just purchase the extension coax and zip tie it to the mast), but to some extent that depends on their availability (delivery times, etc) and cost. @naturesyouth

Tebazil12, 2017-06-04:
That will not happen before this Thursday @Danyc0 , there is already too much work for just Tom to do (everyone is leaving Aber today). The holes for the deck mounts have already been drilled ready for sailbot and we know for sure that like this it works.

Start a new issue for mast mounted antennae for after this competition. We're still not sure on moving the antennae to the mast either way.

Danyc0, 2017-06-04:
I don't quite know what you're envisioning, but what has always been proposed is just connecting a single cable between the deck-mount and the antenna, then zip tying that to the mast for use. It uses the connector which has already been added to the deck.

Tebazil12, 2017-06-04:
Ok, that's different to what I heard before. Are there cables that long with the right connectors that are waterproof that can get here before Thursday? If so we could try it out.

Danyc0, 2017-06-04:
That's always been my plan, I'm glad we're now on the same page. @naturesyouth should know and be able to source one, as he ordered the connectors.

TomGC96, 2017-06-04:
@naturesyouth also paid for them out of his own pocket, and the Bulgin connectors are not cheap so I don't think it's fair to ask him to buy more. The deck antennae increased the range so much I still don't think it's necessary, considering the additional faff. You should also remember there won't be a way to put those antennae flat with the mast, because of the screw connector at its base.

Danyc0, 2017-06-04:
I wouldn't expect him to pay, but either way that's his choice. Remember as well as improving the range, it would also fix the problem that this issue is about, in a way that is a lot less faff (and less permanent) than anything else proposed. What do you mean about the screw connector? I assumed it could just be unscrewed and then folded away with the mast?

TomGC96, 2017-06-04:
The antenna is as seen here: http://bit.ly/2s6AA9V. This blue piece at the bottom attaches to the deck mount in order to seal the connector. As far as I can see, it can't simply be removed.

Danyc0, 2017-06-04:
Wait what? seriously? Why do we bother having a connector at all if it's not removable? haha

naturesyouth, 2017-06-04:
Don't worry, I am here to solve all your antenna problems. First off how much of a problem is the current rigging-antenna setup? on a scale of "would be nice to fix" to "spontaneous unplanned hardware reconfiguration". Also, could I get the diameter and the length of run for the new antenna feed cable?

TomGC96, 2017-06-04:
What I meant, was that we would need it to be like the left image, but with our current antenna, it would look like the one on the right. my.mixtape.moe/kocymo.jpg

Danyc0, 2017-06-04:
what's wrong with the right hand image?

TomGC96, 2017-06-04:
The angle - it's messy, means that the antenna is not straight, and more than anything it puts pressure on the antenna.

naturesyouth, 2017-06-04:
I agree that mounting at that angle is not good, i am gonna suggest fitting a mounting plate on the mast with two bolts and using that to hold the antenna, but i need to know how long the feed cable would need to be.

TomGC96, 2017-06-04:
The problem you have then is that you add a lot of weight to the top of the mast, which will make the boat more unstable. I honestly don't think it's necessary, we were getting massive range out of it in Barmouth. I think we should at least wait until after Sailbot to decide, so we can properly test how good the WiFi and XBee range is with these deck antennae.

naturesyouth, 2017-06-04:
is 200g gonn\a make that much difference? and cat the boat run reliably with the current setup (without any string)

Danyc0, 2017-06-04:
I think at the very least, if it needs a mount, that suddenly becomes a lot more work than is feasible in a couple of days! (on top of what else needs doing).

Re: current setup, It's always a big worry getting the winch cable caught on the antenna, string seems like a bit of a crappy option, especially if it's glued, but I can't really think of anything better for the timescale.

naturesyouth, 2017-06-04:
Ok, so can this issue be fixed by reseating the current deck mounted antenna, at what height does the line interfere on the antenna. And if it's the best solution i can have a extension cable and bracket made up in time for sailbot.

Danyc0, 2017-06-04:
Are you suggesting moving it? If so, that's not feasible in the time, and if not, what do you mean by reseating?
It's not just the fab time, you've got to account for delivery and getting it attached (by someone that isn't you).
Just a quick possibly crap idea, how about sticking a cone over it, so the mainsheet just slides off?

TomGC96, 2017-06-04:
Don't worry, I'll sort something to stop any string or rope from getting stuck on the antennae. It will be better than just some string or cable ties.

naturesyouth, 2017-06-04:
I was planning on fabbing it then attaching it at sailbot, if moving the current bulkhead is a no go how about fitting the second on in a position it doesn't interfere and just capping the first on.

Danyc0, 2017-06-04:
I guess depending on what tom's plans are, there's no harm in you fabbing it all and trying to mount it at sailbot. If it doesn't work/happen/get done in time, just keep what tom has done, if it does work, then great! Also that plan for moving it just sounds horrific.

TomGC96, 2017-06-04:
If you decide to extend the antenna, use the two which are there at the moment, it would be fine to run a cable straight from them as is. They are in pretty much the only position we could see would not interfere with anything else. Preferably, anything new to be done should not interfere with the new paintwork (filling holes in the deck etc.).

Thread 77 (2017-06-04):

Run Wifi Antenna up mast

Danyc0, 2017-06-04:
See discussion in #76

TomGC96, 2017-10-02:
Bracket has been created, and running the antenna up the mast is now possible, however as proven at Sailbot 2017 this was not necessary. With the current setup on the deck, we experienced WiFi range of up to 200m, and XBee range of well over 350m.

colinsauze, 2017-10-02:
Range at Sailbot 2017 may have been helped by an 2nd story balcony used to monitor the boat and receive telemetry. Don't be surprised if range is a lot worse when the ground station is at sea level.

TomGC96, 2017-10-02:
That as it may be, the balcony was only roughly 6 metres higher than the water, and with our distance from the boat being so great, the overall difference in angle between that and us at 2 metres should not be that great.

Closed 2017-10-02.

Thread 78 (2018-03-14):

Repair or replace RC antenna

TomGC96, 2018-03-14:
Antenna on RC is damaged and no longer stays attached to the rest of the controller properly. As a result the coax cable is no longer in the best condition. It may be necessary to replace the whole controller.

colinsauze, 2019-08-21:
A new receiver has been temporarily installed. It belonged to Tom Blanchard and Sam Nichols (Tom and Sam Industrys) but they have both left Aber now.

TomGC96, 2019-08-21:
Can this now be closed @colinsauze?

colinsauze, 2019-08-22:
Not really as current RC receiver is a temporary replacement.

Thread 79 (2018-10-20):

fix broken rudder RC line

colinsauze, 2018-10-20:
Rudder RC control isn't working and the input line to the multiplexer is probably broken. Diagnose and resolder it.

colinsauze, 2019-07-29:
multiplexer wires have been resoldered and RC receiver replaced, seems to be working now.

Closed 2019-07-29.
