abersailbot/dewi-hardware/(commit log)

2015-10-01 wiring diagram for the Dewi electronics
    fairly self explanatory
2015-10-01 manually adding as pull request screwed up
2015-10-01 removed the dodgy wiring diagram file
2016-01-27 Add blank wiring document
2016-01-27 Add wiring standard (from abersailbot/management)
2016-02-01 add basic project files for kicad and first library for freetronics
    [Pi-Expansion.kicad_pcb, Pi-Expansion.sch]
2016-02-14 Finalised Kicad librarys for A2200-A, myriadrf, and pi_Hat, also layout for first draft of Schmatic
2016-02-14 Rejigged librarys abit to be less random, made sure to use submodules instead of local copys. Also did first draft of pcb layout
    [Pi-Expansion.sch]
2016-02-14 Rename Pi-Expansion -> pi-expansion
    Lower case names are nicer to deal with.
    [Pi-Expansion.kicad_pcb, Pi-Expansion.sch]
2016-02-15 added custom library for arduino board with only mounting holes, also added in the hole position for ardino, and refined pcb outline
    [Pi-Expansion.kicad_pcb]
2016-02-15 fixed board outline, moved gps
    [Pi-Expansion.kicad_pcb]
2016-02-16 did a full layout of the pcb, should be pretty much compleat, also fixed yet more issues librarys
    [Pi-Expansion.dsn, Pi-Expansion.kicad_pcb, Pi-Expansion.sch]
2016-02-16 add copper fill for ground plane, and second mill revisions for prototyping
    [Pi-Expansion.kicad_pcb]
2016-05-16 Updated 3v3 and Gnd tabs on pi header on schmatic
    [Pi-Expansion.sch]
2016-05-16 Adds reverse voltage protection for DC-DC converter allowing for safe operation of pi form UUSB connector
    [Pi-Expansion.sch]
2016-05-16 Updated layout around gps, reconfigured for autowakeup and NMEA at 4800.
    [Pi-Expansion.sch]
2016-05-16 minor tweaks, and rotated pi header, removed infill and traces
    [Pi-Expansion.kicad_pcb, Pi-Expansion.sch]
2016-05-19 Made minor tweaks to schematic layout, updated footprints and tweaked pcb layout
    [Pi-Expansion.kicad_pcb, Pi-Expansion.sch]
2016-05-19 First draft pcb layout, most tracks in place, footprints in near final positions
    [Pi-Expansion.kicad_pcb, Pi-Expansion.sch]
2016-05-19 Final Layout, Traces and footprints in place, added GPS_TX sensing circuit 3.3v powerled.
    [Pi-Expansion.kicad_pcb, Pi-Expansion.sch]
2016-05-20 updated power footprints, minor tweaks
    [Pi-Expansion.kicad_pcb]
2016-05-22 Silk screen update, nudged some footprints for better flow.
    [Pi-Expansion.kicad_pcb]
2016-05-22 Final Commit for V1.2 'Captain H.Morgan', all planes, solder masks, and components in final places.
    [Pi-Expansion.kicad_pcb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]
2016-05-22 Documentation update, added notes to schematic.
    [Pi-Expansion.sch]
2016-05-22 Documentation tweaks
    [Pi-Expansion.sch]
2016-05-22 Updated GPS ground Pads
    [Pi-Expansion.kicad_pcb]
2016-05-23 updateded fab files with ground plane fix
    [Pi-Expansion-B.Adhes.gbr, Pi-Expansion-B.CrtYd.gbr, Pi-Expansion-B.Cu.gbr, Pi-Expansion-B.Fab.gbr, Pi-Expansion-B.Mask.gbr, Pi-Expansion-B.Paste.gbr, Pi-Expansion-Cmts.User.gbr, Pi-Expansion-Dwgs.User.gbr]
2016-06-17 made minor mods to power supply including moving reverse protection diode from negitive side to positive side to reduce voltage drop.
    [Pi-Expansion.kicad_pcb, Pi-Expansion.sch]
2016-06-17 minor tweaks to in fill
    [Pi-Expansion.kicad_pcb]
2016-06-18 cleared out fabrication files as they should be generated fresh when needed, also simplified circuitry for the tx sense led
    [Pi-Expansion-B.Adhes.gbr, Pi-Expansion-B.CrtYd.gbr, Pi-Expansion-B.Cu.gbr, Pi-Expansion-B.Fab.gbr, Pi-Expansion-B.Mask.gbr, Pi-Expansion-B.Paste.gbr, Pi-Expansion-B.SilkS.gbr, Pi-Expansion-Cmts.User.gbr]
2016-06-18 Added current limiting resistor for GPS TX indicator, also fiddled with Copper fill
    [Pi-Expansion.kicad_pcb, _saved_Pi-Expansion.sch]
2016-06-18 updated led resistor placement so they no longer obstruct the legand on the silk screen
    [Pi-Expansion.kicad_pcb]
2016-06-30 Final version sent to fab, retraced GPS_TX to fix net issue between 2k2 resistor and pi header
    [Pi-Expansion.kicad_pcb, Pi-Expansion.sch, _saved_Pi-Expansion.sch]
2016-09-07 Added voltage select jumper to VANT.
    [Pi-Expansion.sch]
2016-10-16 Added voltage select for GPS Vant between 5v and 3v3.
    [Pi-Expansion.kicad_pcb, Pi-Expansion.sch]
2016-11-21 Updated silkscreen typo.
    [Pi-Expansion.kicad_pcb]
2016-11-21 Nudged silkscreen for @tomgc96
    [Pi-Expansion.kicad_pcb]
2016-11-21 moved url to silkscreen and updated it for .co.uk address
    [Pi-Expansion.kicad_pcb]
2016-11-21 Moved led vias and traces to clear around silkscreen.
    [Pi-Expansion.kicad_pcb]
2016-11-21 de-capitalised gpsd
    [Pi-Expansion.kicad_pcb]
2016-11-25 Moved captian morgan files to seperate repo and removed copies in this repo. all files related to captain morgan can now be found in: https://github.com/abersailbot/Captain-H-Morgan
    [Pi-Expansion.dsn, Pi-Expansion.kicad_pcb, Pi-Expansion.sch]
2016-11-25 Updated the wiring standard to inclued infomation about current handeling, and servo wiring
2016-11-25 moved wiring standard to docs repo.
